lightside-instruments/orangecrab-hardware/hardware/orangecrab_r0.2.1/OrangeCrab.kicad_pcb

## KiCad design hardware/orangecrab_r0.2.1/OrangeCrab.kicad_pcb (2026-06-19)

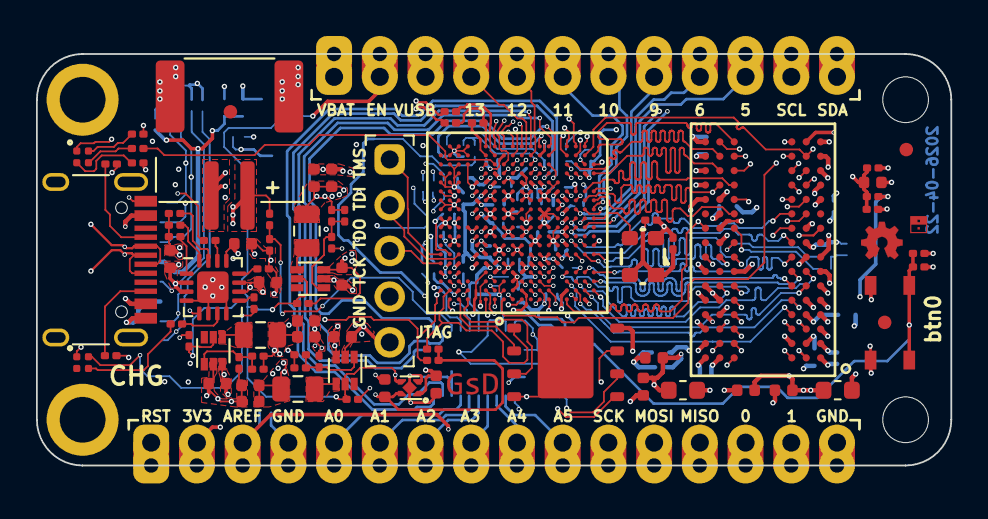
[picture p1: board OrangeCrab.kicad_pcb from above]

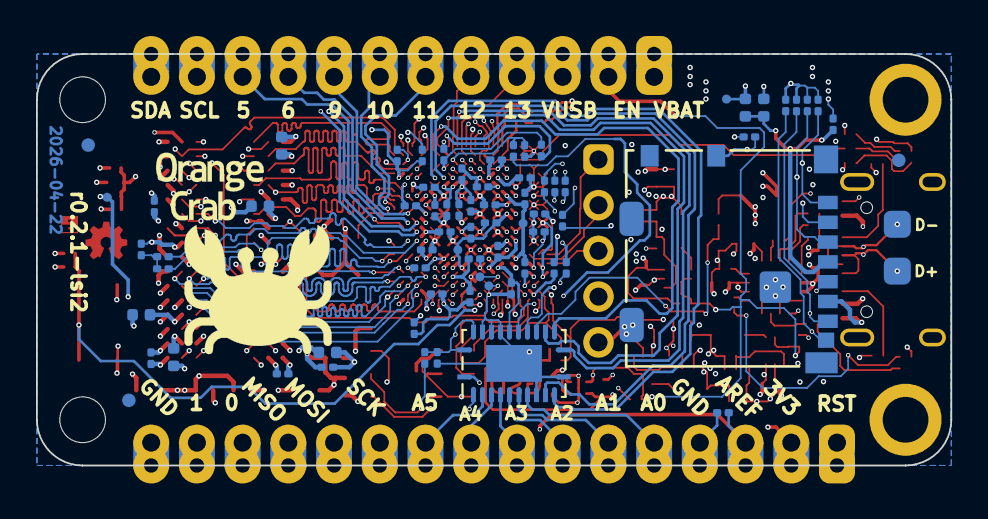
[picture p2: board OrangeCrab.kicad_pcb from below]

Board: 6 copper layers, 50.8 x 22.9 mm, 161 parts (74 on the bottom side), 152 nets.

Parts:
C1, C19, C25, C48, C49, C52, C53, C56, C58, C60, C62, C63, C66, C67, C74, C76: 10nF; C_0201_0603Metric
C2, C4, C20, C26, C27, C28, C30, C31, C32, C33, C50, C51, C54, C55, C57, C59, C61, C64, C65, C68, C69, C70, C71, C75: 100nF; C_0201_0603Metric
C3, C21, C22, C34, C35, C36, C37: 1uF; C_0402_1005Metric
C5, C10, C18: 10pF; C_0201_0603Metric
C6, C7, C8, C9, C11, C14, C15, C16, C17, C29: 10uF; C_0402_1005Metric
C12, C13, C46, C47, C77: 4.7uF; C_0402_1005Metric
C23, C24: 22uF; C_0603_1608Metric
D1, D2: LED_ARGB; 0404LED_RGB
FB1, FB2, FB3: 600R; L_0402_1005Metric
FID1, FID2, FID3, FID4, FID5, FID6: Fiducial; Fiducial_0.75mm_Mask1.5mm
H1, H2: MountingHole; MountingHole_2.2mm_M2_Pad
H3, H4: MountingHole; MountingHole_2.1mm
J1: Conn_01x12_Male; Feather_PinHeader_1x12
J2: Conn_01x16_Male; Feather_PinHeader_1x16
J3: USB_C_Receptacle_USB2.0; USB_C_Receptacle_HRO_TYPE-C-31-M-12
J4: MicroSd; molex_microsd_1040310811
J5: JST; JST_PH_B2B-PH-SM4-TB_1x02-1MP_P2.00mm_Vertical
J6: Conn_01x05_Male; PinHeader_1x05_P2.54mm_Vertical
L1, L2, L3: 2.2uH; L_0805_2012Metric
OSC1: KC2520B48.0000C10E00; Oscilator_2.5x2.0
R1, R2: 1k; R_0201_0603Metric
R3, R5, R6, R13, R48, R49, R50, R51: 51R; R_0201_0603Metric
R4, R8, R23, R27, R30, R39: 4.7k; R_0201_0603Metric
R7, R25, R26, R28, R32, R33, R40, R41, R42, R43, R44, R45: 10k; R_0201_0603Metric
R9, R24: 3.57k; R_0201_0603Metric
R10: 56.2k; R_0201_0603Metric
R11: 3.09k; R_0201_0603Metric
R12: 4.32k; R_0201_0603Metric
R14, R16, R46: 5.1k; R_0201_0603Metric
R15, R35: 120k; R_0201_0603Metric
R17: 100k; R_0201_0603Metric
R18, R36: DNP; R_0201_0603Metric
R19: 240R; R_0402_1005Metric
R20, R22, R31: 1.5k; R_0201_0603Metric
R21, R29: 20R; R_0201_0603Metric
R34: 150k; R_0201_0603Metric
R37: 360k; R_0201_0603Metric
R38: 82k; R_0201_0603Metric
SW1: SW_Push; PTS_810_SMT_Switch
TP19, TP20, TP26, TP27, TP29, TP30, TP31, TP32: SMD_TP; TestPoint_Pad_D0.5mm
U1, U2, U7: TLV62569DRL; SOT-563
U3: LFE5U-25F-8MG285C; csBGA285
U4: MT41K64M16TW-107_J-TR; BGA-96_9.0x13.0mm_Layout2x3x16_P0.8mm
U5: BQ24232; QFN-16-1EP_3x3mm_P0.5mm_EP1.75x1.75mm
U6: W25Q128JVP; WSON-8-1EP_6x5mm_P1.27mm_EP3.4x4mm
U9: 74HC4067BQ; Texas_RGY_R-PVQFN-N24_EP2.05x3.1mm
U10: NCP115-2.5; Texas_X2SON-4_1x1mm_P0.65mm
lsi-logo: G***; lsi-logo-no-text-1mm

Connections:
/DRAM/RAM_VDD: C21.1, C23.1, C30.1, C32.1, C34.1, C36.1, FB2.1, U4.B2, U4.D9, U4.G7, U4.K2, U4.K8, U4.N1, U4.N9, U4.R1, U4.R9
/DRAM/RAM_VDDQ: C22.1, C24.1, C31.1, C33.1, C35.1, C37.1, FB3.1, U4.A1, U4.A8, U4.C1, U4.C9, U4.D2, U4.E9, U4.F1, U4.H2, U4.H9
/DRAM/RAM_ZQ: R19.1, U4.L8
/IO/A0: J2.5, R48.1, U9.8
/IO/A1: J2.6, R49.1, U9.7
/IO/A2: J2.7, R50.1, U9.6
/IO/A3: J2.8, R51.1, U9.5
/IO/A4: J2.9, R6.1, U9.4
/IO/A5: J2.10, R3.1, U9.3
/IO/AREF: C71.1, J2.3, U9.2
/IO/_USB_D_N: J3.A7, J3.B7, R29.2, TP27.1
/IO/_USB_D_P: J3.A6, J3.B6, R21.1, TP26.1
ADC_CTRL0: R46.1, U3.G1
ADC_CTRL1: U3.F1, U9.15
ADC_MUX0: U3.F4, U9.10
ADC_MUX1: U3.F3, U9.11
ADC_MUX2: U3.F2, U9.14
ADC_MUX3: U3.H1, U9.13
ADC_SENSE_HI: R44.2, R45.2, U3.H3
ADC_SENSE_LO: C28.1, R46.2, U3.G3
ECP5_VREF: C1.1, C2.1, C3.1, C4.1, C19.1, C20.1, C25.1, C26.1, R1.2, R2.1, U3.B4, U3.C15, U3.H15, U4.H1, U4.M8
EN: J1.2, R18.1, R25.1, R36.1, U1.5, U2.5, U7.5, U10.3
EXT_PLL+: TP19.1, U3.M16
EXT_PLL-: TP20.1, U3.M17
FPGA_RESET: J2.1, R39.1, U3.T15, U3.V17
GND: C1.2, C2.2, C3.2, C4.2, C6.1, C7.1, C8.1, C9.1, C11.1, C12.2, C13.2, C14.1, C15.1, C16.1, C17.1, C19.2, C20.2, C21.2, C22.2, C23.2, C24.2, C25.2, C26.2, C27.2, C28.2, C29.1, C30.2, C31.2, C32.2, C33.2, C34.2, C35.2, C36.2, C37.2, C46.2, C47.2, C48.2, C49.2, C50.2, C51.2, C52.2, C53.2, C54.2, C55.2, C56.2, C57.2, C58.2, C59.2, C60.2, C61.2, C62.2, C63.2, C64.2, C65.2, C66.2, C67.2, C68.2, C69.2, C70.1, C71.2, C74.2, C75.2, C76.2, C77.2, J2.4, J2.16, J3.A1, J3.A12, J3.B1, J3.B12, J3.S1, J4.6, J4.MP, J5.1, J5.MP, J6.5, OSC1.2, R2.2, R9.1, R10.1, R11.1, R12.1, R14.2, R15.2, R16.2, R19.2, R26.1, R27.1, R33.2, R35.2, R38.2, R45.1, SW1.1, U1.2, U2.2, U3.B3, U3.B16, U3.E5, U3.E7, U3.E8, U3.E9, U3.E10, U3.E11, U3.E12, U3.E14, U3.F5, U3.F6, U3.F7, U3.F8, U3.F9, U3.F10, U3.F11, U3.F12, U3.F13, U3.F14, U3.G2, U3.G6, U3.G7, U3.G8, U3.G9, U3.G10, U3.G11, U3.G12, U3.G13, U3.G17, U3.H6, U3.H7, U3.H8, U3.H9, U3.H10, U3.H11, U3.H12, U3.H13, U3.J6, U3.J7, U3.J8, U3.J9, U3.J10, U3.J11, U3.J12, U3.J13, U3.K5, U3.K6, U3.K7, U3.K8, U3.K9, U3.K10, U3.K11, U3.K12, U3.K13, U3.K14, U3.L2, U3.L5, U3.L6, U3.L7, U3.L8, U3.L9, U3.L10, U3.L11, U3.L12, U3.L13, U3.L14, U3.L15, U3.L16, U3.L17, U3.M6, U3.M7, U3.M8, U3.M9, U3.M10, U3.M11, U3.M12, U3.M13, U3.N7, U3.N8, U3.N9, U3.N10, U3.N11, U3.N12, U3.P5, U3.P6, U3.P8, U3.P10, U3.P12, U3.R1, U3.R2, U3.R3, U3.R10, U3.T1, U3.T2, U3.T3, U3.T4, U3.T5, U3.T6, U3.T7, U3.T8, U3.T9, U3.T10, U3.T11, U3.T12, U3.T16, U3.U1, U3.U2, U3.U3, U3.U4, U3.U5, U3.U6, U3.U7, U3.U8, U3.U9, U3.U10, U3.U11, U3.U12, U3.U14, U3.V4, U3.V5, U3.V6, U3.V7, U3.V8, U3.V9, U3.V10, U3.V15, U4.A9, U4.B1, U4.B3, U4.B9, U4.D1, U4.D8, U4.E1, U4.E2, U4.E8, U4.F9, U4.G1, U4.G9, U4.J2, U4.J8, U4.M1, U4.M9, U4.P1, U4.P9, U4.T1, U4.T9, U5.4, U5.6, U5.8, U5.17, U6.4, U7.2, U9.9, U9.12, U9.20, U9.21, U9.22, U10.2
IO_0: J2.14, U3.N17
IO_1: J2.15, U3.M18
IO_5: J1.10, U3.B10
IO_6: J1.9, U3.B9
IO_9: J1.8, U3.C8
IO_10: J1.7, U3.B8
IO_11: J1.6, U3.A8
IO_12: J1.5, U3.H2
IO_13: J1.4, U3.J2
IO_A0: R48.2, U3.L4
IO_A1: R49.2, U3.N3
IO_A2: R50.2, U3.N4
IO_A3: R51.2, U3.H4
IO_A4: R6.2, U3.G4
IO_A5: R3.2, U3.T17
IO_MISO: J2.13, U3.N15
IO_MOSI: J2.12, U3.N16
IO_SCK: J2.11, U3.R17
IO_SCL: J1.11, U3.C9
IO_SDA: J1.12, U3.C10
JTAG_TCK: J6.4, R27.2, U3.U13
JTAG_TDI: J6.2, U3.T13
JTAG_TDO: J6.3, U3.V14
JTAG_TMS: J6.1, U3.V13
LED_B: R24.1, U3.J3
LED_G: R23.1, U3.M3
LED_R: R22.1, U3.K4
unnamed: C5.1, R15.1, R17.1, U1.1
unnamed: C10.1, R34.1, R35.1, U2.1
unnamed: C18.1, R37.1, R38.1, U7.1
unnamed: C27.1, R5.1, R13.1
unnamed: C29.2, C70.2, FB1.1, J4.4
unnamed: D1.2, R22.2
unnamed: D1.3, R23.2
unnamed: D1.4, R24.2
unnamed: D2.2, R8.2
unnamed: D2.3, R7.2
unnamed: J3.A5, R16.1
unnamed: J3.B5, R14.1
unnamed: L1.1, U1.4
unnamed: L2.1, U2.4
unnamed: L3.1, U7.4
unnamed: R7.1, U5.7
unnamed: R8.1, U5.9
unnamed: R9.2, U5.15
unnamed: R10.2, U5.14
unnamed: R11.2, U5.12
unnamed: R12.2, U5.16
unnamed: R26.2, U5.1
unnamed: R32.2, R33.1, U9.16
unnamed: R44.1, U9.1
P1.1V: C5.2, C15.2, C17.2, C48.1, C50.1, C52.1, C54.1, C56.1, C57.1, C58.1, C59.1, C60.1, C61.1, L1.2, R17.2, TP32.1, U3.D8, U3.D9, U3.D10, U3.D11, U3.J4, U3.J5, U3.J14, U3.J15, U3.M4, U3.M15, U3.P7, U3.P9, U3.P11, U9.17
P1.35V: C8.2, C9.2, C10.2, C62.1, C64.1, C66.1, C68.1, FB2.2, FB3.2, L2.2, R1.1, R4.1, R34.2, TP31.1, U3.B18, U3.C6, U3.D17, U3.G5, U3.G14, U3.H5, U3.H14, U3.K15, U3.K16, U3.K17, U3.M14, U3.N14, U9.19
P2.5V: C47.1, C49.1, C51.1, C53.1, C55.1, TP30.1, U3.E6, U3.E13, U3.N6, U3.P13, U9.18, U10.1
P3.3V: C14.2, C16.2, C18.2, C46.1, C63.1, C65.1, C67.1, C69.1, C74.1, C75.1, D1.1, FB1.2, J2.2, J2.e, L3.2, OSC1.1, OSC1.4, R28.1, R30.2, R31.2, R37.2, R39.2, R40.1, R41.1, R42.1, R43.1, TP29.1, U3.D7, U3.D12, U3.M5, U3.N5, U3.N13, U3.P14, U3.T14, U6.8, U9.23, U9.24, U10.4
PUSB_VBUS: C77.1, J1.3, J3.A4, J3.A9, J3.B4, J3.B9, U5.13
QSPI_D2: U3.R18, U6.3
QSPI_D3: U3.N18, U6.7
RAM_A0: U3.C4, U4.N3
RAM_A1: U3.D2, U4.P7
RAM_A2: U3.D3, U4.P3
RAM_A3: U3.A3, U4.N2
RAM_A4: U3.A4, U4.P8
RAM_A5: U3.D4, U4.P2
RAM_A6: U3.C3, U4.R8
RAM_A7: U3.B2, U4.R2
RAM_A8: U3.B1, U4.T8
RAM_A9: U3.D1, U4.R3
RAM_A10: U3.A7, U4.L7
RAM_A11: U3.C2, U4.R7
RAM_A12: U3.B6, U4.N7
RAM_A13: U3.C1, U4.T3
RAM_A14: U3.A2, U4.T7
RAM_A15: U3.C7, U4.M7
RAM_BA0: U3.D6, U4.M2
RAM_BA1: U3.B7, U4.N8
RAM_BA2: U3.A6, U4.M3
RAM_CAS#: U3.D13, U4.K3
RAM_CK+: R5.2, U3.J18, U4.J7
RAM_CK-: R13.2, U3.K18, U4.K7
RAM_CKE: U3.D18, U4.K9
RAM_CS#: U3.A12, U4.L2
RAM_D0: U3.C17, U4.E3
RAM_D1: U3.D15, U4.F7
RAM_D2: U3.B17, U4.F2
RAM_D3: U3.C16, U4.F8
RAM_D4: U3.A15, U4.H3
RAM_D5: U3.B13, U4.H8
RAM_D6: U3.A17, U4.G2
RAM_D7: U3.A13, U4.H7
RAM_D8: U3.F17, U4.D7
RAM_D9: U3.F16, U4.C3
RAM_D10: U3.G15, U4.C8
RAM_D11: U3.F15, U4.C2
RAM_D12: U3.J16, U4.A7
RAM_D13: U3.C18, U4.A2
RAM_D14: U3.H16, U4.B8
RAM_D15: U3.F18, U4.A3
RAM_LDM: U3.G16, U4.E7
RAM_LDQS+: U3.G18, U4.C7
RAM_LDQS-: U3.H17, U4.B7
RAM_ODT: U3.C13, U4.K1
RAM_RAS#: U3.C12, U4.J3
RAM_RESET#: U3.L18, U4.T2
RAM_UDM: U3.D16, U4.D3
RAM_UDQS+: U3.B15, U4.F3
RAM_UDQS-: U3.A16, U4.G3
RAM_WE#: U3.B12, U4.L3
REF_CLK: OSC1.3, U3.A9
SD0_CD: J4.9, R28.2, U3.L1
SD0_CLK: J4.5, U3.K1
SD0_CMD: J4.3, R42.2, U3.K2
SD0_DAT0: J4.7, R41.2, U3.J1
SD0_DAT1: J4.8, R40.2, U3.K3
SD0_DAT2: J4.1, R43.2, U3.L3
SD0_DAT3: J4.2, U3.M1
SPI_CONFIG_MISO: U3.T18, U6.2
SPI_CONFIG_MOSI: U3.U18, U6.5
SPI_CONFIG_SCK: R31.1, U3.U16, U6.6
SPI_CONFIG_SS: R30.1, U3.U17, U6.1
USB_D+: R20.1, R21.2, U3.N1
USB_D-: R29.1, U3.M2
USB_PULLUP: R20.2, U3.N2
USER_BUTTON: C76.1, R4.2, SW1.2, U3.J17
VBATT: C13.1, J1.1, J5.2, R32.1, U5.2, U5.3
VSYS: C6.2, C7.2, C11.2, C12.1, D2.1, R18.2, R25.2, R36.2, U1.3, U2.3, U5.5, U5.10, U5.11, U7.3
