lightside-instruments/orangecrab-hardware/(commit log)

2025-12-26 kicad7 update
    [DECOUPLING.kicad_sch, DECOUPLING.sch, DRAM.kicad_sch, DRAM.sch, FPGA.kicad_sch, FPGA.sch, IO.kicad_sch, IO.sch]
2026-01-28 kicad9 update
    [DECOUPLING.kicad_sch, DRAM.kicad_sch, FPGA.kicad_sch, IO.kicad_sch, OrangeCrab.kicad_pcb, OrangeCrab.kicad_sch, POWER.kicad_sch, SDMMC.kicad_sch]
2026-01-29 Changed min. via diameter from 0.28 to 0.25 mm. Rounded min. trace width to 0.9 mm and DDR3 traces down to 0.1 mm
    [OrangeCrab.kicad_pcb]
2026-01-29 Added revision suffix gc1 to indicate the changed layout: 0.2.1-gc1
    [OrangeCrab.kicad_pcb]
2026-01-30 0.2.1-gc2: Centered castelated holes to edges and reduced diameter from 1 to 0.8 mm
    [OrangeCrab.kicad_pcb]
2026-04-22 0.2.1-li1: Changed the type pads of castellated holes in KiCAD to flag they are castellated holes. Moved version string for better visibility. Added missing USB connector to BOM. Changed from 25F to 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
    [OrangeCrab.kicad_pcb, bom.csv]
2026-06-19 0.2.1-lsi2: Added 1 mm 'produced by' mark
    [OrangeCrab.kicad_pcb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]
