lightside-instruments/orangecrab-hardware/(notices)

Notices in the files:
hardware/orangecrab_r0.2.1/DECOUPLING.kicad_sch:
Licensed under CERN OHL v.1.2
